ykstudio3695-boop/CHORDION/ハードウェア/KiCad_data/pocket_synth.png

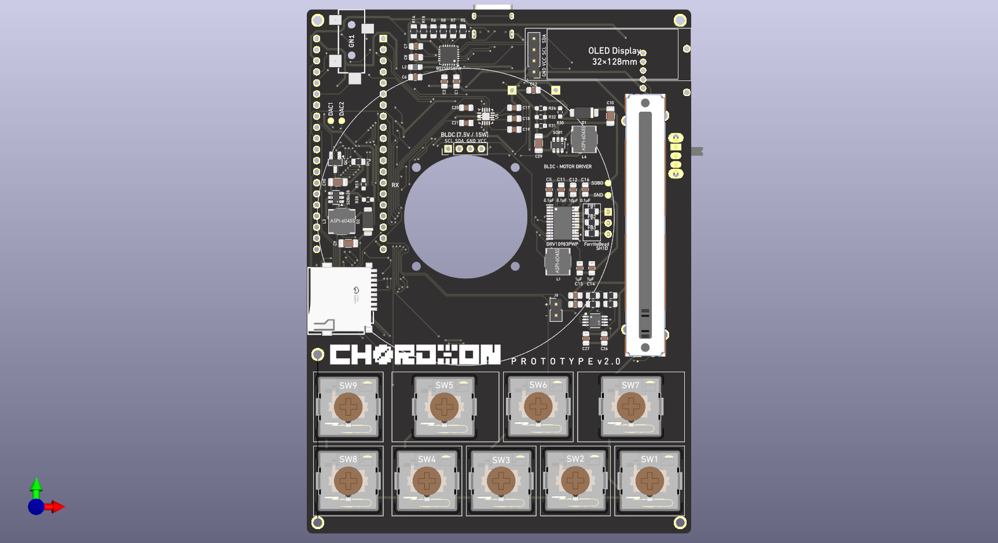
ハードウェア/KiCad_data/pocket_synth.png
