ykstudio3695-boop/CHORDION/ハードウェア/BOM.md

# CHORDION - Hardware Parts List (部品表)

[English](#english) / [日本語](#日本語)

---

## English

This is the Bill of Materials (BOM) for the CHORDION hardware components.

### 1. Electronic Components
| Part Name | Specification | Qty | Value | Source / Link | Note |
| :--- | :--- | :---: | :--- | :--- | :--- |
| Microcontroller | Teensy4.1 | 1 |  | [Link](https://amzn.asia/d/0gJBUKr6) | |
| Switch | Kailh Shadow Hunting | 9 | | [Link](https://amzn.asia/d/01fGJeuc) | |
| OLED | 32x128 | 1 | | [Link](https://amzn.asia/d/0bGwvaTc) | |

### 2. Mechanical & Structural Parts
| Part Name | Material / Process | Qty | Source / Link | Note |
| :--- | :--- | :---: | :--- | :--- |
| Top Case | 3D Printed (PLA) | 1 | `CAD/` folder | |
| Screw | M3 x 8mm | 6 | [Link]() | |

---

## 日本語

CHORDIONのハードウェア部品表（BOM）です。

### 1. 電子部品
| 部品名 | 規格・型番 | 数量 | 価格 | 購入先・リンク | 備考 |
| :--- | :--- | :--- | :--- | :--- | :--- |
| マイコン | Teensy4.1 | 1 | | [リンク](https://amzn.asia/d/0gJBUKr6) | |
| スイッチ | Kailh Shadow Hunting | 9 | | [リンク](https://amzn.asia/d/01fGJeuc) | |
| OLED | 32x128 | 1 | | [リンク](https://amzn.asia/d/0bGwvaTc) | |

### 2. 機構・外装部品
| 部品名 | 材質・加工方法 | 数量 | 購入先・リンク | 備考 |
| :--- | :--- | :---: | :--- | :--- |
| トップケース | 3Dプリント (PLA) | 1 | `CAD/` フォルダ内 | |
| ネジ | M3 x 8mm | 6 | [リンク]() | |
