ykstudio3695-boop/CHORDION/ハードウェア/BOM/マイコン.md

### 購入リンク
https://fiveg.net/?pid=177975976&srsltid=AU7gw4Xf4F5X3NUbWpul7TbUS9suSAcb14UydaRFC6NurnHR8C-kI4Va 

### データシート
https://www.electrokit.com/upload/product/41020/41020659/Daisy_Seed_datasheet_v1.0.5.pdf

### フットプリント
https://docs.daisy.audio/hardware/#daisy-boards
