ykstudio3695-boop/CHORDION/ハードウェア/BOM/ヘッドフォンジャック.md

### 商品リンク
https://www.digikey.jp/ja/products/detail/same-sky-formerly-cui-devices/SJ-3524-SMT-TR/281298

### データシート
https://www.sameskydevices.com/product/resource/sj-352x-smt.pdf

### フットプリント
https://www.digikey.jp/ja/models/281298?tab=snapmagic
