ykstudio3695-boop/CHORDION/ハードウェア/BOM/スライドボリューム.md

### 商品リンク
**https://www.digikey.jp/ja/products/detail/bourns-inc/PTA4543-2015DPB103/3534245**
    
### データシート
**https://documentation.espressif.com/esp32-c3-wroom-02_datasheet_en.pdf**

### フットプリント
**https://www.snapeda.com/parts/ESP32-C3-WROOM-02-N4/Espressif%20Systems/view-part/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**
