ykstudio3695-boop/CHORDION/ハードウェア/BOM/液晶ディスプレイモジュール.md

### 商品ページ
**https://amzn.asia/d/0g94sdli**
    
### データシート
**None**

### フットプリント
**KiCad / Connector_PinHeader_2.54mm:PinHeader_1x04_P2.54mm_Vertical**
