ykstudio3695-boop/CHORDION/ハードウェア/BOM/スピーカーアンプ.md

### 商品リンク
https://www.digikey.jp/ja/products/detail/texas-instruments/TPA2005D1DGNR/1670402

### データシート
https://www.ti.com/general/docs/suppproductinfo.tsp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

### フットプリント
https://www.digikey.jp/ja/models/1670402?tab=snapmagic
