ykstudio3695-boop/CHORDION/ハードウェア/BOM/昇圧レギュレータ.md

### 商品リンク
https://amzn.asia/d/04BqAedb

### データシート
None

### フットプリント
None
