ykstudio3695-boop/CHORDION/ハードウェア/BOM/音量ボリューム.md

### 購入リンク
https://www.digikey.jp/ja/products/detail/alps-alpine/RK10J12E0A0A/21721435

### データシート
https://tech.alpsalpine.com/e/products/detail/RK10J12E0A0A/

### フットプリント
https://www.snapeda.com/parts/RK10J12E0A0A/ALPS/view-part/?ref=search&t=RK10J&ab_test_case=b
