ykstudio3695-boop/CHORDION/ハードウェア/BOM/SDカードスロット.md

### 商品リンク / TF PUSH - SHOU HAN
**https://jlcpcb.com/partdetail/SHOUHAN-TFPUSH/C393941** 
### データシート
**上記URLから直接ダウンロード**
### フットプリント
windowsの場合、Easy EDA 2kicadというサービスを利用してダウンロードする

**ツールインストール**

pip install easyeda2kicad

**すべてまとめてダウンロード**

easyeda2kicad --full --lcsc_id=C393941
