ykstudio3695-boop/CHORDION/ハードウェア/KiCad_data/pocket_synth.step

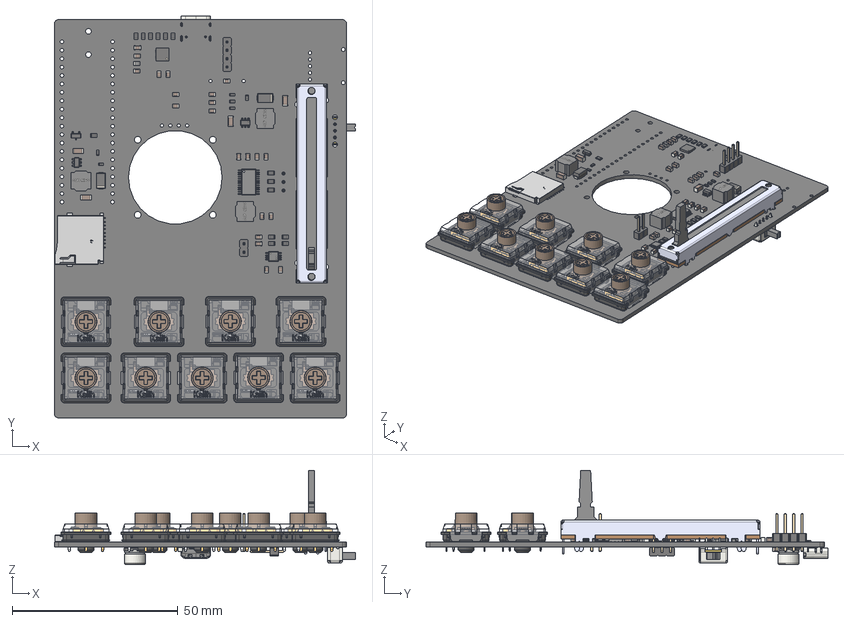
[picture p2: CAD file, 2026-10-18]
ハードウェア/KiCad_data/pocket_synth.step
90.7 x 121.1 x 28.4 mm
Texas_RTW_WQFN-24-1EP_4x4mm_P0.5mm_EP2.7x2.7mm
PinHeader_1x02_P2.54mm_Vertical
ASPI-6045S-470M-T x 3
C_0805_2012Metric x 22
bottom x 9
contact x 9
top x 9
stem_tactile x 9
pin1 x 9
pin2 x 9
pin3 x 9
shrunken_spring x 9
R_0805_2012Metric x 16
R_0603_1608Metric x 6
TF-SMD_TF-PUSH
SOT-23
D_SMA x 2
C_1206_3216Metric x 4
DRV10983PWP
PTA4543-2015DPB103
SOT-23-6 x 2
L_0805_2012Metric
MSOP-8_L3.0-W3.0-P0.65-LS5.0-BR-EP
PinHeader_1x04_P2.54mm_Vertical
CP_Elec_6.3x5.2
PinHeader_1x03_P2.54mm_Horizontal
USB_C_Receptacle_GCT_USB4105-xx-A_16P_TopMnt_Horizontal
SW_Slide_SPDT_Angled_CK_OS102011MA1Q
pocket_synth_PCB
