ykstudio3695-boop/CHORDION/ファームウェア/teensy/AudioSampleHihat.cpp

// Audio data converted from WAV file by wav2sketch

#include <Arduino.h>
#include "AudioSampleHihat.h"

// Converted from HIHAT.wav, using 44100 Hz, u-law encoding
PROGMEM const unsigned int AudioSampleHihat[15553] = {
0x0100F300,0x00000000,0x00000000,0x00000000,0x00000000,0x00000000,0x00000000,0x00000000,
0x00000000,0x00000000,0x00000000,0x00000000,0x00000000,0x00000000,0x00000000,0x00000000,
0x00000000,0x00000000,0x00000000,0x00000000,0x00000000,0x00000000,0x00000000,0x00000000,
0x00000000,0x00000000,0x00000000,0x00000000,0x00000000,0x00000000,0x00000000,0x00000000,
0x00000000,0x00000000,0x00000000,0x00000000,0x00000000,0x00000000,0x00000000,0x00000000,
0x00000000,0x00000000,0x00000000,0x00000000,0x00000000,0x00000000,0x00000000,0x00000000,
0x00000000,0x00000000,0x00000000,0x00000000,0x00000000,0x00000000,0x00000000,0x00000000,
0x00000000,0x00000000,0x00000000,0x00000000,0x00000000,0x00000000,0x00000000,0x00000000,
0x00000000,0x00000000,0x00000000,0x00000000,0x00000000,0x00000000,0x00000000,0x00000000,
0x00000000,0x00000000,0x00000000,0x00000000,0x00000000,0x00000000,0x00000000,0x00000000,
0x00000000,0x00000000,0x00000000,0x00000000,0x00000000,0x00000000,0x00000000,0x00000000,
0x00000000,0x00000000,0x00000000,0x00000000,0x00000000,0x00000000,0x00000000,0x00000000,
0x00000000,0x00000000,0x00000000,0x00000000,0x00000000,0x00000000,0x00000000,0x00000000,
0x00000000,0x00000000,0x00000000,0x00000000,0x00000000,0x00000000,0x00000000,0x00000000,
0x00000000,0x00000000,0x00000000,0x00000000,0x00000000,0x00000000,0x00000000,0x00000000,
0x00000000,0x00000000,0x00000000,0x00000000,0x00000000,0x00000000,0x00000000,0x00000000,
0x00000000,0x00800000,0x00000080,0x00800000,0x00000000,0x00000000,0x80000000,0x00000000,
0x80800000,0x00000000,0x00000000,0x00000000,0x00000000,0x00800000,0x00000000,0x00000000,
0x00000000,0x80000000,0x00000000,0x00000000,0x00000000,0x00000000,0x00000000,0x00000000,
0x80800000,0x00000000,0x80000000,0x00000000,0x00000000,0x00000080,0x00000000,0x00000000,
0x00000000,0x00000000,0x80000080,0x80000000,0x00000000,0x00000080,0x00808000,0x00000000,
0x00000000,0x00000000,0x00000000,0x80000000,0x00000000,0x00008080,0x00800000,0x00800000,
0x80000000,0x00000000,0x00000000,0x00000000,0x00000080,0x00008000,0x00008000,0x80800000,
0x00000000,0x80000000,0x80000080,0x00000000,0x00808000,0x00000000,0x00000000,0x00800000,
0x00000000,0x00000000,0x00008000,0x00000000,0x00000000,0x00008080,0x00000000,0x00000000,
0x80800000,0x80800000,0x00800000,0x00000000,0x00000000,0x80008080,0x00000080,0x00000000,
0x80000000,0x80000080,0x00000000,0x00008080,0x00000000,0x00008000,0x80000080,0x00000000,
0x80808000,0x80000000,0x80000080,0x00000000,0x00008000,0x80000000,0x00008080,0x00000000,
0x00000080,0x80800080,0x80000000,0x00800000,0x00000000,0x00808000,0x80800000,0x00808000,
0x00808000,0x80000000,0x80000080,0x80000000,0x00008080,0x80800000,0x00000080,0x00008000,
0x00008080,0x80818000,0x80800100,0x80800000,0x80800000,0x80800080,0x80810101,0x03828200,
0x81838004,0x82000100,0x80010182,0x00010200,0x00818282,0x83000302,0x05008282,0x04018301,
0x04008683,0x86888003,0x85840A09,0x05858202,0x80838206,0x03828180,0x01898109,0x0A028504,
0x04018B85,0x8F840602,0x84850B02,0x8086040B,0x0A0C8584,0x8A00868A,0x87800F80,0x81840609,
0x040B8888,0x0D118391,0x8B928503,0x15048305,0x0D0B9005,0x85109095,0x05130993,0x95900E0D,
0x1511848F,0x0B099085,0x858D8583,0x03948010,0x80070915,0x11129399,0x918D0302,0x8A93100F,
0x8A910C16,0x17180381,0x0B8DA196,0x9013160C,0x82140895,0x90118093,0x86181297,0xA69E170D,
0x950B230E,0x0F15098E,0x14019994,0x0A809102,0x9A0B0F03,0x1E200C9E,0x09A4A00C,0x0A900220,
0x13949307,0x988E1C24,0x2592A5A0,0x95920E26,0xA3132002,0x998011A1,0x228D1D15,0xA9BB9832,
0x09912027,0x95A21924,0xA5B02230,0x14B1A51A,0xA88E212F,0xA11E299C,0x9C123321,0x26A0A389,
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
};
