ykstudio3695-boop/CHORDION/ファームウェア/teensy/AudioSampleKick.cpp

// Audio data converted from WAV file by wav2sketch

#include <Arduino.h>
#include "AudioSampleKick.h"

// Converted from KICK.wav, using 44100 Hz, u-law encoding
PROGMEM const unsigned int AudioSampleKick[14977] = {
0x0100EA00,0x00000000,0x00000000,0x00000000,0x00000000,0x00000000,0x00000000,0x00000000,
0x00000000,0x00000000,0x00000000,0x00000000,0x00000000,0x00000000,0x00000000,0x00000000,
0x00000000,0x00000000,0x00000000,0x00000000,0x00000000,0x00000000,0x00000000,0x00000000,
0x00000000,0x00000000,0x00000000,0x00000000,0x00000000,0x00000000,0x00000000,0x00000000,
0x00000000,0x00000000,0x00000000,0x00000000,0x00000000,0x00000000,0x00000000,0x00000000,
0x00000000,0x00000000,0x00000000,0x00000000,0x00000000,0x00000000,0x00000000,0x00000000,
0x00000000,0x00000000,0x00000000,0x00000000,0x00000000,0x00000000,0x00000000,0x00000000,
0x00000000,0x00000000,0x00000000,0x00000000,0x00000000,0x00000000,0x00000000,0x00000000,
0x00000000,0x00000000,0x00000000,0x00000000,0x00000000,0x00000000,0x00000000,0x00000000,
0x00000000,0x00000000,0x00000000,0x00000000,0x00000000,0x00000000,0x00000000,0x00000000,
0x00000000,0x00000000,0x00000000,0x00000000,0x00000000,0x00000000,0x00000000,0x00000000,
0x00000000,0x00000000,0x00000000,0x00000000,0x00000000,0x00000000,0x00000000,0x00000000,
0x00000000,0x00000000,0x00000000,0x00000000,0x00000000,0x00000000,0x00000000,0x00000000,
0x00000000,0x00000000,0x00000000,0x00000000,0x00000000,0x00000000,0x00000000,0x00000000,
0x00000000,0x00000000,0x00000000,0x00000000,0x00000000,0x00000000,0x00000000,0x00000000,
0x00000000,0x00000000,0x00000000,0x00000000,0x00000000,0x00000000,0x00000000,0x00000000,
0x00000000,0x00000000,0x00000000,0x00000000,0x00000000,0x00000000,0x00000000,0x00000000,
0x00000000,0x00000000,0x00000000,0x00000000,0x00000000,0x00000000,0x00000000,0x00000000,
0x00000000,0x00000000,0x00000000,0x00000000,0x00000000,0x00000000,0x00000000,0x00000000,
0x00000000,0x00000000,0x00000000,0x00000000,0x00000000,0x00000000,0x00000000,0x00000000,
0x00000000,0x00008000,0x00000000,0x00000000,0x00000000,0x00000000,0x00000000,0x00000000,
0x00000000,0x00000000,0x00000000,0x00000000,0x00000000,0x00000000,0x00000000,0x00000000,
0x00000000,0x00000000,0x00000000,0x00000000,0x00000000,0x00000000,0x00000000,0x00000000,
0x00000000,0x00000000,0x00000000,0x00000000,0x00000000,0x00000000,0x00000000,0x00000000,
0x00000000,0x00000000,0x00000000,0x00000000,0x00000000,0x00000000,0x00000000,0x00000000,
0x00000000,0x00000000,0x00000000,0x00000000,0x80000000,0x00000000,0x00000000,0x00000000,
0x00000000,0x00000000,0x00000000,0x00000000,0x00000000,0x00000000,0x00000000,0x00000000,
0x00000000,0x00000000,0x00000000,0x00000000,0x80800000,0x00008080,0x00000000,0x00808000,
0x80000000,0x00000000,0x00000000,0x00000000,0x00000000,0x00000080,0x00000000,0x00000000,
0x00000000,0x00808000,0x80800000,0x00008000,0x80800000,0x00808080,0x80000000,0x00800000,
0x80000000,0x00010100,0x80800000,0x00000000,0x80010100,0x02018081,0x80800001,0x80000080,
0x03028081,0x01808100,0x80810002,0x03008000,0x82810104,0x02818382,0x81000506,0x00838100,
0x85800606,0x01060680,0x80000000,0x81010181,0x81090C03,0x08088086,0x09090201,0x03858800,
0x060C0A07,0x0B058080,0x02848009,0x0D090505,0x8480070C,0x01010480,0x05030606,0x01030002,
0x0A048385,0x90850A0F,0x8D8B8B90,0x1003868A,0x8E8D8110,0x94928F8F,0x020C088D,0x84868986,
0x989C968C,0x80070389,0x8C8B9391,0x89848890,0x818D8C8A,0x93938606,0x00038690,0x93840085,
0x0F100291,0x83959785,0x930F1711,0x17118B99,0x08899207,0x0B919000,0x0C10181B,0x0F8B998E,
0x03969108,0x880D2020,0x92031000,0x8E830190,0x2220108A,0x9C051D21,0x031C1199,0x98969C9B,
0x232D218C,0x16839F92,0xA2A68A16,0x95801D12,0x21210695,0xA1A59312,0x83911513,0x158E8512,
0xA1941722,0x272F2293,0xA281191B,0x969F99A2,0x3E362D19,0x2429353F,0x84121822,0xACA4A4A0,
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
};
