ykstudio3695-boop/CHORDION/ファームウェア/teensy/AudioSampleSnare.cpp

// Audio data converted from WAV file by wav2sketch

#include <Arduino.h>
#include "AudioSampleSnare.h"

// Converted from SNARE.wav, using 44100 Hz, u-law encoding
PROGMEM const unsigned int AudioSampleSnare[11809] = {
0x0100B880,0x00000000,0x00000000,0x00000000,0x00000000,0x00000000,0x00000000,0x00000000,
0x00000000,0x00000000,0x00000000,0x00000000,0x00000000,0x00000000,0x00000000,0x00000000,
0x00000000,0x00000000,0x00000000,0x00000000,0x00000000,0x00000000,0x00000000,0x00000000,
0x00000000,0x00000000,0x00000000,0x00000000,0x00000000,0x00000000,0x00000000,0x00000000,
0x00000000,0x00000000,0x00000000,0x00000000,0x00000000,0x00000000,0x00000000,0x00000000,
0x00000000,0x00000000,0x00000000,0x00000000,0x00000000,0x00000000,0x00000000,0x00000000,
0x00000000,0x00000000,0x00000000,0x00000000,0x00000000,0x00000000,0x00000000,0x00000000,
0x00000000,0x00000000,0x00000000,0x00000000,0x00000000,0x00000000,0x00000000,0x00000000,
0x00000000,0x00000000,0x00000000,0x00000000,0x00000000,0x00000000,0x00000000,0x00000000,
0x00000000,0x00000000,0x00000000,0x00000000,0x00000000,0x00000000,0x00000000,0x00000000,
0x00000000,0x00000000,0x00000080,0x00000000,0x00000000,0x00000000,0x00000000,0x00000000,
0x00000000,0x00000000,0x80008080,0x00000080,0x00000000,0x00000000,0x00000000,0x00000000,
0x00000000,0x00000000,0x00000000,0x00000000,0x00000000,0x00008000,0x00000000,0x00008000,
0x00000000,0x00808000,0x00000000,0x80808080,0x00000000,0x00000000,0x00000000,0x00000000,
0x00000000,0x00000000,0x00000000,0x00000000,0x00000080,0x00000000,0x00000000,0x00000000,
0x00000000,0x80800000,0x00000000,0x00000000,0x00000000,0x00000080,0x00000000,0x00000000,
0x00000000,0x00000000,0x00000000,0x80800000,0x80800080,0x80808080,0x80808080,0x80808080,
0x00000080,0x00000000,0x00000000,0x00000000,0x00000000,0x00008000,0x00000000,0x00000000,
0x80000000,0x80000000,0x80800000,0x00008080,0x00808000,0x00008000,0x80808080,0x00000000,
0x00000000,0x00000000,0x80000000,0x00000080,0x00000000,0x00000000,0x00000000,0x00008000,
0x80000000,0x00008080,0x00000080,0x80808080,0x80808080,0x80808080,0x80808080,0x00000080,
0x00000080,0x00000000,0x00000000,0x00000000,0x00000000,0x00000000,0x00000000,0x00000000,
0x80808000,0x80008080,0x00000080,0x00000000,0x00000000,0x00000000,0x00000000,0x00000000,
0x00008000,0x80808080,0x00008080,0x00000080,0x00000000,0x00000000,0x00000000,0x00000000,
0x00000000,0x00000000,0x80000000,0x00008080,0x00000000,0x00800000,0x00808000,0x00000000,
0x00000000,0x00800000,0x00000000,0x00008080,0x00000000,0x80808080,0x80808080,0x80000080,
0x80800080,0x80808080,0x80800000,0x80808000,0x80000080,0x00000000,0x80008080,0x80800000,
0x00008080,0x00000000,0x00000000,0x00000000,0x00000000,0x00000000,0x00000000,0x00000000,
0x00000000,0x00000000,0x00000000,0x00000000,0x00000000,0x00000000,0x00000000,0x00000000,
0x00808080,0x01010101,0x00000000,0x01010000,0x80000101,0x01018081,0x00010101,0x00000000,
0x03030100,0x80000203,0x02010081,0x00000001,0x03020100,0x04050403,0x00000001,0x02040200,
0x00818280,0x06090703,0x01010103,0x06030000,0x00070A08,0x0A028687,0x050B0E0D,0x04040201,
0x15140D06,0x86020B12,0x0E100586,0x02020206,0x1719150B,0x030B1012,0x08028283,0x850D110D,
0x1A128390,0x86101C1E,0x06080386,0x85020102,0x9A989591,0x92050A90,0x8E989999,0x8C840A0A,
0x9389888C,0x8A8B9096,0x938D0C08,0x92928584,0x0E8C9491,0x111E201A,0x88890306,0x8C968309,
0x11101313,0x91979883,0x90959290,0x93081910,0x86A4A69F,0xA4A08913,0xA0A3A7A7,0x969DA1A1,
0xADB1A89B,0x221E0B9B,0x9CA6A10E,0x85838288,0xA8A5A193,0x1B93A8AC,0x82811120,0x1F039891,
0xA29E9018,0x2304A5A8,0x131B1820,0x170F8B8B,0x1F2E281E,0x209AA9A0,0x2F33322F,0x1F282222,
0x322F2312,0x13253436,0x2E29271F,0x91902030,0x23322D15,0x11262716,0x39290B05,0xC1C2B52C,
0xC3C3C4C3,0xCDCAC6C4,0xC1C2C3CA,0xAFC1C0BD,0x0D312A14,0x2E4539A0,0x8F1E268A,0x61584D33,
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
};
