ykstudio3695-boop/CHORDION/ファームウェア/teensy/AudioSampleTom_h.cpp

// Audio data converted from WAV file by wav2sketch

#include <Arduino.h>
#include "AudioSampleTom_h.h"

// Converted from TOM_H.wav, using 44100 Hz, u-law encoding
PROGMEM const unsigned int AudioSampleTom_h[21889] = {
0x01015600,0x00000000,0x00000000,0x00000000,0x00000000,0x00000000,0x00000000,0x00000000,
0x00000000,0x00000000,0x00000000,0x00000000,0x00000000,0x00000000,0x00000000,0x00000000,
0x00000000,0x00000000,0x00000000,0x00000000,0x00000000,0x00000000,0x00000000,0x00000000,
0x00000000,0x00000000,0x00000000,0x00000000,0x00000000,0x00000000,0x00000000,0x00000000,
0x00000000,0x00000000,0x00000000,0x00000000,0x00000000,0x00000000,0x00000000,0x00000000,
0x00000000,0x00000000,0x00000000,0x00000000,0x00000000,0x00000000,0x00000000,0x00000000,
0x00000000,0x00000000,0x00000000,0x00000000,0x00000000,0x00000000,0x00000000,0x00000000,
0x00000000,0x00000000,0x00000000,0x00000000,0x00000000,0x00000000,0x00000000,0x00000000,
0x00000000,0x00000000,0x00000000,0x00000000,0x00000000,0x00000000,0x00000000,0x00000000,
0x00000000,0x00000000,0x00000000,0x00000000,0x00000000,0x00000000,0x00000000,0x00000000,
0x00000000,0x00000000,0x00000000,0x00000000,0x00000000,0x00000000,0x00000000,0x00000000,
0x00000000,0x00000000,0x00000000,0x00000000,0x00000000,0x00000000,0x00000000,0x00000000,
0x00000000,0x00000000,0x00000000,0x00000000,0x00000000,0x00000000,0x00000000,0x00000000,
0x00000000,0x00000000,0x00000000,0x00000000,0x00000000,0x00000000,0x00000000,0x00000000,
0x00000000,0x00000000,0x00000000,0x00000000,0x00000000,0x00000000,0x00000000,0x00000000,
0x00000000,0x00000000,0x00000000,0x00000000,0x00000000,0x00000000,0x00000000,0x00000000,
0x00000000,0x00000000,0x00000000,0x00000000,0x00000000,0x00000000,0x00000000,0x00000000,
0x00000000,0x00000000,0x00000000,0x00000000,0x00000000,0x00000000,0x00000000,0x00000000,
0x00000000,0x00000000,0x00000000,0x00000000,0x00000000,0x00000000,0x00000000,0x00000000,
0x00000000,0x00000000,0x00000000,0x00000000,0x00000000,0x00000000,0x00000000,0x80800000,
0x00000000,0x00000000,0x00000000,0x00000000,0x00000000,0x00000000,0x00000000,0x00000000,
0x00000000,0x00000000,0x00000000,0x00000000,0x00000080,0x00000000,0x00000000,0x00000000,
0x00000000,0x00000000,0x00000000,0x00000000,0x80000000,0x00000080,0x00000000,0x00000000,
0x00000000,0x00000000,0x00000000,0x00000000,0x00000000,0x00000000,0x00000000,0x00000000,
0x80808000,0x00000080,0x00000000,0x00000000,0x00000000,0x00000000,0x00000000,0x00000080,
0x00000000,0x00000000,0x00000000,0x00000000,0x00000000,0x00000000,0x00000000,0x00000000,
0x00000000,0x00000000,0x80008080,0x00000080,0x00000000,0x80808000,0x00000000,0x00000000,
0x00000000,0x00000000,0x00000080,0x00000000,0x00000000,0x00000000,0x00000000,0x80800000,
0x00008080,0x00000000,0x00000080,0x80808000,0x00008080,0x00000000,0x80808080,0x00000000,
0x00000080,0x80800000,0x00008080,0x00000000,0x00008080,0x80000000,0x00010080,0x80000000,
0x80808081,0x00010080,0x00008080,0x81800000,0x00808181,0x00010100,0x82818180,0x80020181,
0x02028082,0x82000101,0x00818485,0x03050401,0x01808000,0x83000404,0x05060282,0x85020504,
0x8181878A,0x00080680,0x04068287,0x87868582,0x09068186,0x87830005,0x05818B8C,0x81020405,
0x00090581,0x89888B8B,0x0D0F0487,0x83000206,0x0C088489,0x0C028780,0x02090609,0x878E918C,
0x0B0A0482,0x858B8604,0x01060905,0x0F058383,0x8C00080F,0x90939695,0x030E0A86,0x02828586,
0x93890709,0x14110290,0x8E0A1213,0x8B929B9B,0x03141083,0x14138491,0x9A958F03,0x1B108E99,
0x05151A1D,0x859AA096,0x90870308,0x1D21128A,0xA1989007,0x120497A2,0x82121514,0x1C0F989A,
0x9BA4A384,0x27210492,0x989B931A,0x09A0A6A0,0x95990E1E,0x12111610,0xA2A69C05,0x201C0C94,
0x94131D1F,0x02A0AAA7,0x1A828C08,0x96911020,0x85A8A99F,0x8BA19018,0x9C970E18,0x94968B90,
0xA4B0A491,0x82272F1E,0xA6A6A8A4,0x95AAADA9,0x05121E1B,0x85A2A495,0x1BAFAB89,0xB9A6313A,
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
};
