ykstudio3695-boop/CHORDION/ファームウェア/teensy/AudioSampleTom_l.cpp

// Audio data converted from WAV file by wav2sketch

#include <Arduino.h>
#include "AudioSampleTom_l.h"

// Converted from TOM_L.wav, using 44100 Hz, u-law encoding
PROGMEM const unsigned int AudioSampleTom_l[25921] = {
0x01019500,0x00000000,0x00000000,0x00000000,0x00000000,0x00000000,0x00000000,0x00000000,
0x00000000,0x00000000,0x00000000,0x00000000,0x00000000,0x00000000,0x00000000,0x00000000,
0x00000000,0x00000000,0x00000000,0x00000000,0x00000000,0x00000000,0x00000000,0x00000000,
0x00000000,0x00000000,0x00000000,0x00000000,0x00000000,0x00000000,0x00000000,0x00000000,
0x00000000,0x00000000,0x00000000,0x00000000,0x00000000,0x00000000,0x00000000,0x00000000,
0x00000000,0x00000000,0x00000000,0x00000000,0x00000000,0x00000000,0x00000000,0x00000000,
0x00000000,0x00000000,0x00000000,0x00000000,0x00000000,0x00000000,0x00000000,0x00000000,
0x00000000,0x00000000,0x00000000,0x00000000,0x00000000,0x00000000,0x00000000,0x00000000,
0x00000000,0x00000000,0x00000000,0x00000000,0x00000000,0x00000000,0x00000000,0x00000000,
0x00000000,0x00000000,0x00000000,0x00000000,0x00000000,0x00000000,0x00000000,0x00000000,
0x00000000,0x00000000,0x00000000,0x00000000,0x00000000,0x00000000,0x00000000,0x00000000,
0x00000000,0x00000000,0x00000000,0x00008000,0x00000000,0x00000000,0x00000000,0x00000000,
0x00000000,0x00000000,0x00000000,0x00000000,0x00000000,0x00000000,0x00000080,0x00000000,
0x00000000,0x00000000,0x00000000,0x80000000,0x00000000,0x00000000,0x00000000,0x00000000,
0x00800000,0x00000000,0x00008000,0x00000000,0x00000000,0x00000000,0x00000000,0x00000000,
0x00000000,0x80000000,0x00000080,0x00000000,0x00000000,0x80000000,0x00000000,0x00000000,
0x00808000,0x80000000,0x00000080,0x00000000,0x00000000,0x80808000,0x00000000,0x00000000,
0x00800000,0x80000000,0x80808080,0x00000000,0x80000000,0x80808080,0x00000000,0x00000000,
0x00000000,0x00000000,0x00000000,0x00000000,0x00000000,0x00000000,0x00000000,0x00000000,
0x00800000,0x80000000,0x00000080,0x00000000,0x00008080,0x00000000,0x80800000,0x00000080,
0x00000000,0x00000000,0x00000000,0x00000000,0x00808000,0x00000000,0x00000000,0x00000000,
0x00808000,0x80808080,0x00000000,0x00000000,0x80000000,0x00000080,0x00000000,0x00808080,
0x00000000,0x80800000,0x00000000,0x00000000,0x00000000,0x00000000,0x80808000,0x00808080,
0x00000000,0x80800000,0x00000000,0x00000000,0x00008080,0x00000000,0x00000000,0x00000000,
0x80000000,0x00000000,0x00000000,0x00000000,0x80808080,0x80000080,0x80808080,0x80808080,
0x80808080,0x00000000,0x00000000,0x00000000,0x00000000,0x00000000,0x00000000,0x00000000,
0x00000000,0x00000000,0x00000000,0x80808080,0x80808000,0x80808080,0x80808080,0x00808080,
0x00800000,0x00000000,0x00000000,0x80808000,0x00000080,0x80000000,0x00808080,0x80800000,
0x80808080,0x80000080,0x00000000,0x00808000,0x80000000,0x00008080,0x00800000,0x00000000,
0x81800000,0x80808081,0x02008080,0x82800203,0x01808283,0x82800102,0x01818383,0x81000203,
0x81808081,0x00818282,0x00010101,0x00808080,0x82000201,0x04018183,0x83830003,0x01040280,
0x00008181,0x85828181,0x0D828A8A,0x90001013,0x09839194,0x8B010A0D,0x0D879292,0x88021215,
0x8A838387,0x82889090,0x070B0702,0x02888780,0x8D091411,0x0C019094,0x88888506,0x130A848A,
0x9C968111,0x120E8496,0x0183800C,0x8A949285,0x110C0903,0xA2980312,0x2019829D,0xA3A08918,
0x21190399,0x95062024,0x03191191,0x909AA19B,0x10110982,0x1917110B,0x8A121818,0x1405999C,
0x96A9A790,0x2B2D2A1E,0xA6A18122,0x2E28129C,0xA3A38824,0x0B929499,0x0E282E25,0x9FA3A39C,
0x322E2187,0xB4B2912A,0x212B22A1,0x94868A04,0x201C8D9D,0xA5A5990C,0x02100C97,0x272F2510,
0x1DA6B098,0x0A222D2F,0xB2B7B1A0,0x3C42390E,0xADB5B01F,0x302A1599,0xAFAA8D24,0x0F2B2895,
0x3C2F829A,0xC9C6AD34,0x474018BC,0xC5AA3746,0x4325BFCA,0xC0204146,0x1FBAC7C9,0x35434642,
0x83BBC3AC,0xD0C1A41F,0x4193C7D2,0xCFC79142,0x4535A9C7,0xB2354C4D,0x23B8C0BE,0x44464440,
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
};
