ykstudio3695-boop/CHORDION/ファームウェア/teensy/AudioSampleTom_m.cpp

// Audio data converted from WAV file by wav2sketch

#include <Arduino.h>
#include "AudioSampleTom_m.h"

// Converted from TOM_M.wav, using 44100 Hz, u-law encoding
PROGMEM const unsigned int AudioSampleTom_m[16129] = {
0x0100FC00,0x00000000,0x00000000,0x00000000,0x00000000,0x00000000,0x00000000,0x00000000,
0x00000000,0x00000000,0x00000000,0x00000000,0x00000000,0x00000000,0x00000000,0x00000000,
0x00000000,0x00000000,0x00000000,0x00000000,0x00000000,0x00000000,0x00000000,0x00000000,
0x00000000,0x00000000,0x00000000,0x00000000,0x00000000,0x00000000,0x00000000,0x00000000,
0x00000000,0x00000000,0x00000000,0x00000000,0x00000000,0x00000000,0x00000000,0x00000000,
0x00000000,0x00000000,0x00000000,0x00000000,0x00000000,0x00000000,0x00000000,0x00000000,
0x00000000,0x00000000,0x00000000,0x00000000,0x00000000,0x00000000,0x00000000,0x00000000,
0x00000000,0x00000000,0x00000000,0x00000000,0x00000000,0x00000000,0x00000000,0x00000000,
0x00000000,0x00000000,0x00000000,0x00000000,0x00000000,0x00000000,0x00000000,0x00000000,
0x00000000,0x00000000,0x00000000,0x00000000,0x00000000,0x00000000,0x00000000,0x00000000,
0x00000000,0x00000000,0x00000000,0x00000000,0x00000000,0x00000000,0x00000000,0x00000000,
0x00000000,0x00000000,0x00000000,0x00000000,0x00000000,0x00000000,0x00000000,0x00000000,
0x00000000,0x00000000,0x00000000,0x00000000,0x00000000,0x00000000,0x00000000,0x00000000,
0x00008000,0x00000000,0x00000000,0x00000000,0x00000000,0x00000000,0x00000000,0x00000000,
0x00000000,0x00000000,0x00000000,0x00808000,0x00000000,0x00000000,0x00000000,0x00000000,
0x00000000,0x00000000,0x00000000,0x00000000,0x00000000,0x00000000,0x00000000,0x00000000,
0x00000000,0x00000000,0x00000000,0x00000000,0x00000000,0x00000000,0x00000000,0x00000000,
0x80008000,0x00000080,0x00000000,0x00000000,0x00000000,0x00000000,0x00000000,0x00000000,
0x00000000,0x00000000,0x00000000,0x00000000,0x00000000,0x00000000,0x00000000,0x00000000,
0x00000000,0x00008000,0x00000000,0x00000000,0x00000000,0x00000000,0x00000000,0x00000000,
0x00000000,0x00000000,0x00000000,0x00800000,0x00800000,0x00000000,0x00000000,0x00000000,
0x00000000,0x00000000,0x00000000,0x00000000,0x00000000,0x00000000,0x00000000,0x80000000,
0x00000000,0x00000000,0x80808000,0x00000080,0x00000000,0x00000000,0x00000000,0x00000000,
0x00000000,0x00000000,0x00000000,0x00000000,0x00000000,0x00000000,0x80000000,0x00000080,
0x80808080,0x80000000,0x00000000,0x00000000,0x80000000,0x00000000,0x00800000,0x00000000,
0x00000000,0x00000000,0x00000000,0x00000000,0x00000000,0x00000000,0x00000000,0x00000000,
0x00000000,0x00000000,0x00000000,0x00808000,0x00000000,0x00000000,0x00008080,0x00000000,
0x80000000,0x00000080,0x80800000,0x00000000,0x00808000,0x80800000,0x00008080,0x80808000,
0x80000000,0x00808080,0x80000000,0x80808080,0x00000080,0x80000000,0x80818080,0x01008080,
0x81800001,0x00008182,0x80808000,0x00000000,0x01808181,0x81800101,0x01010081,0x80818100,
0x82000201,0x01818384,0x00020403,0x85838000,0x03808384,0x01040605,0x85868582,0x0A048083,
0x87830208,0x04038388,0x81868580,0x82030605,0x09818988,0x8D87030B,0x080B0388,0x818C8C81,
0x9204110C,0x0D879599,0x84121C19,0x969A9791,0x1C16088A,0x998D0D19,0x0A909C9E,0x15110D11,
0x9C8B0612,0x1B1291A0,0x9A950618,0x11181389,0x92938D80,0x08121201,0x19019188,0x9A950119,
0x20210C95,0x9799930E,0x1E069194,0xA0812024,0x04949DA3,0x121B211D,0x9DA6A28C,0x1E232007,
0xA69B8411,0x292487A4,0xA1A1921B,0x841C1C8D,0x1B098F96,0x96901120,0x220E9498,0xA2A48920,
0x262A2300,0x919FA104,0x958E8889,0x31332905,0xB7AF9323,0x311EA5B6,0x81283334,0xA3B9B7AA,
0x2D36382D,0x8CB0B192,0xA01A2D28,0x2A96AEAE,0xB69E2833,0x353504B5,0xB4B5A61E,0x2A302799,
0xB0AB9F10,0x20281CA5,0xA3A48017,0x10928281,0xB195151E,0x3824AEB9,0xB397303B,0x2D98B8BA,
0x201F0724,0xBA8E1406,0xAFBAC2C4,0xC2C4B5A3,0x363728AB,0x2C849C22,0x05303232,0x412AB1B4,
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
};
