ykstudio3695-boop/CHORDION/(commit log)

2026-06-28 Add CAD tools and descriptions
2026-06-28 Create BOM for CHORDION hardware components
    Added a Bill of Materials (BOM) for CHORDION hardware components in both English and Japanese.
2026-06-28 Update and rename BOM to BOM.md
2026-06-28 Revise BOM with detailed components and links
    Updated the Bill of Materials (BOM) to include specific components and their sources.
2026-06-28 Create documentation for Teensy test program
    Added documentation for Teensy test program, including requirements and important notices in both English and Japanese.
2026-10-17 READMEへの仮の変更。
    まだあんまり書くことが定まってない
2026-10-18 BLDC専用IC.md を追加
2026-10-18 液晶ディスプレイ.md追加
    Updated product page and footprint information for the LCD module.
2026-10-18 スライドボリューム.md 追加
2026-10-18 SDカードスロット.md追加
    Added documentation for SD card slot including product link, datasheet, and footprint download instructions.
2026-10-18 音量ボリューム.md追加
2026-10-18 ヘッドフォンジャック.md追加
2026-10-18 マイコン.md追加
2026-10-18 昇圧レギュレータ.md追加
2026-10-18 スピーカーアンプ.md追加
